Dee-24r/stratosphere/assets/gamecontroller.png

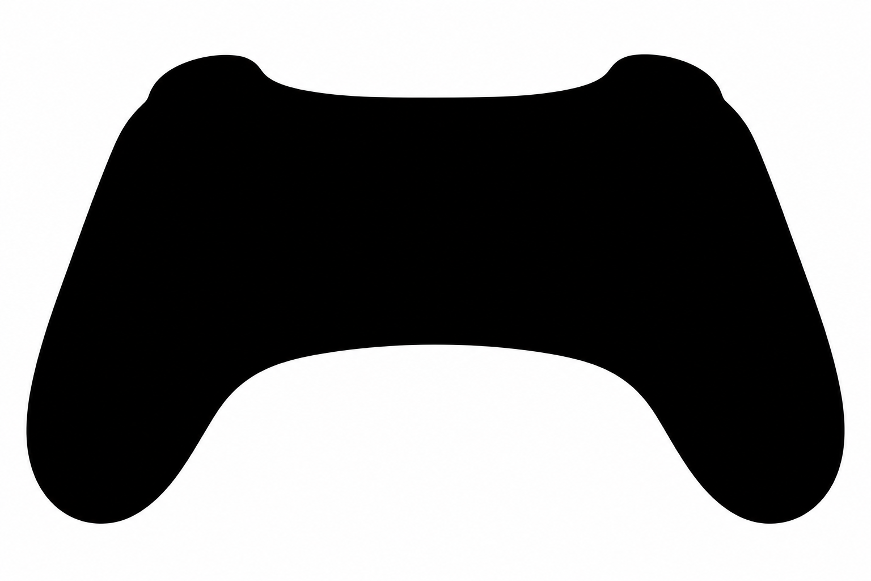
assets/gamecontroller.png
