Dee-24r/stratosphere/pcb/drone-bom.csv

No. | Quantity | Comment | Designator | Footprint | Value | Manufacturer Part | Manufacturer | Supplier Part | Supplier
1 | 2 | Test-Point | BAT+,BAT- | Test-Point-0.5mm
2 | 4 | 1uF | C1,C2,C3,C4 | C0402 | 1uF | TCC0402X5R105M6R3AT | CCTC(三环) | C2887021 | LCSC
3 | 1 | 1uF | C5 | C0603 | 1uF | CC0603KRX7R7BB105 | YAGEO(国巨) | C106248 | LCSC
4 | 2 | 10uF | C6,C11 | C0603 | 10uF | CC0603MRX5R7BB106 | YAGEO(国巨) | C109457 | LCSC
5 | 2 | 10uF | C7,C8 | C0603 | 10uF | CC0603MRX5R6BB106 | YAGEO(国巨) | C109453 | LCSC
6 | 2 | 10uF | C9,C10 | C0402 | 10uF | CC0402MRX6S5BB106 | YAGEO(国巨) | C1856484 | LCSC
7 | 2 | 1uF | C12,C13 | C0603 | 1uF | CC0603KRX7R9BB105 | YAGEO(国巨) | C559769 | LCSC
8 | 1 | 100nF | C14 | C0603 | 100nF | CC0603KRX7R9BB104 | YAGEO(国巨) | C14663 | LCSC
9 | 4 | 1N4148W | D1,D2,D3,D4 | SOD-123_L2.8-W1.8-LS3.7-RD-1 |  | 1N4148W | JSMSEMI(杰盛微) | C917030 | LCSC
10 | 2 | SS14 | D5,D6 | SMA_L4.3-W2.6-LS5.0-RD |  | SS14 | YONGYUTAI(永裕泰) | C47147601 | LCSC
11 | 4 | PZ254V-11-02P | H1,H2,H3,H4 | HDR-TH_2P-P2.54-V-M |  | PZ254V-11-02P | XFCN(兴飞) | C492401 | LCSC
12 | 1 | 2.2uH | L1 | L0805 | 2.2uH | CMI201209U2R2KT | FH(风华) | C1043 | LCSC
13 | 1 | YLED0603R | LED1 | LED0603-FD |  | YLED0603R | YONGYUTAI(永裕泰) | C19171390 | LCSC
14 | 1 | KT-0603R | LED2 | LED-SMD_L1.6-W0.8-R-RD |  | KT-0603R | KENTO | C2286 | LCSC
15 | 4 | SI2300DS-T1-GE3 | Q1,Q2,Q3,Q4 | SOT-23-3_L2.9-W1.6-P1.90-LS2.8-BR |  | SI2300DS-T1-GE3 | VISHAY(威世) | C72271 | LCSC
16 | 4 | 10kΩ | R1,R2,R3,R4 | R0603 | 10kΩ | FRC0603F1002TS | FOJAN(富捷) | C2906982 | LCSC
17 | 2 | 1kΩ | R5,R6 | R0603 | 1kΩ | RC0603FR-071KL | YAGEO(国巨) | C22548 | LCSC
18 | 2 | 5.1kΩ | R7,R8 | R0603 | 5.1kΩ | RC0603FR-075K1L | YAGEO(国巨) | C105580 | LCSC
19 | 1 | 100Ω | R9 | R0603 | 100Ω | RC0603FR-07100RL | YAGEO(国巨) | C105588 | LCSC
20 | 2 | 100kΩ | R10,R11 | R0603 | 100kΩ | 0603WAF1003T5E | UNI-ROYAL(厚声) | C25803 | LCSC
21 | 2 | 1kΩ | R12,R13 | R0402 | 1kΩ | FRC0402J102 TS | FOJAN(富捷) | C2906899 | LCSC
22 | 1 | 1.1kΩ | R14 | R0603 | 1.1kΩ | RC0603FR-071K1L | YAGEO(国巨) | C137780 | LCSC
23 | 1 | 330Ω | R15 | R0402 | 330Ω | RC0402JR-07330RL | YAGEO(国巨) | C105876 | LCSC
24 | 2 | TSA010B2018A | SW1,SW2 | SW-SMD_L3.9-W3.0-P4.45 |  | TSA010B2018A | BZCN(博众电气) | C2888920 | LCSC
25 | 1 | SS12D07VG6 087 | SW3 | SW-TH_SS12D07VG4 |  | SS12D07VG6 087 | SHOU HAN(首韩) | C2939728 | LCSC
26 | 1 | 2.54-1*8 | U1 | HDR-TH_8P-P2.54-V-M |  | 2.54-1*8 | ZHOURI(洲日) | C5156616 | LCSC
27 | 1 | TP4056 | U2 | ESOP-8_L4.9-W3.9-P1.27-LS6.0-BL-EP |  | TP4056 | UMW(友台半导体) | C725790 | LCSC
28 | 1 | TPS63001DRCR | U3 | VSON-10_L3.0-W3.0-P0.50-TL-EP_TPS62410DRCR |  | TPS63001DRCR | TI(德州仪器) | C28060 | LCSC
29 | 1 | YLED0603G | U4 | LED0603-FD |  | YLED0603G | YONGYUTAI(永裕泰) | C19273151 | LCSC
30 | 1 | 2.4GHz | U5 | WIRELM-SMD_ESP32-S3-WROOM-1 | 2.4GHz | ESP32-S3-WROOM-1-N16R8 | ESPRESSIF(乐鑫) | C2913202 | LCSC
31 | 1 | MC-403L68-Z10 | USB3 | USB-TYPE-C-SMD_MC-403L68-Z10 |  | MC-403L68-Z10 | HANBO(汉博) | C47326496 | LCSC
