Dee-24r/stratosphere/assets/new-control-step.step

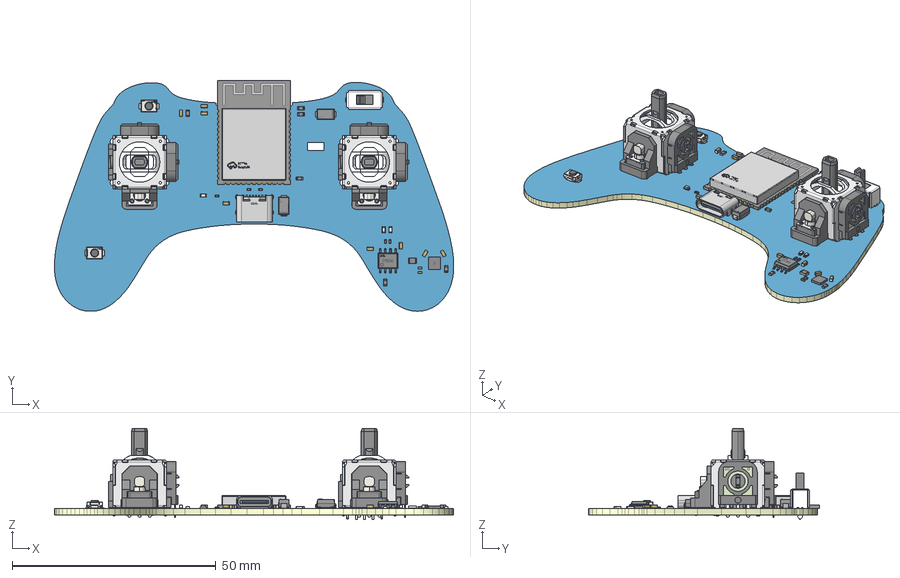
[picture p8: CAD file, 2026-11-08]
assets/new-control-step.step
98.0 x 56.6 x 22.4 mm
Board~3STp
TopCopper~3STp
BottomCopper~3STp
TopSilkscreen~3STp
BottomSilkscreen~3STp
TopFpcStiffener~3STp
BottomFpcStiffener~3STp
R0402~R0402_L1.0-W0.5-H0.4~BPKo x 5
SMA_L4.3-W2.6-LS5.0-RD~SMA_L4.3-W2.6-LS5.0-RD~HQWF x 2
C0603~C0603_L1.6-W0.8-H0.8~hneH x 8
L0805~R0805_L2.0-W1.3-H0.6~7Ztj
R0603~R0603~T6XA x 6
SW-SMD_L3.9-W3.0-P4.45~SW-SMD_L3.9-W2.9-H2.0-LS4.8~sBa6 x 2
C0402~C0402_L1.0-W0.5-H0.5~hx1S x 2
VSON-10_L3.0-W3.0-P0.50-TL-EP_TPS62410DRCR~VSON-10_L3.0-W3.0-H0.6-P0.50_TPS~7Heo
LED-SMD_L1.6-W0.8-R-RD~LED0603_L1.6-W0.8-H0.6~277s
SW-TH_SS12D07VG4~SW-TH_SS12D07VG4~FqVL
USB-TYPE-C-SMD_MC-403L68-Z10~USB-TYPE-C-SMD_MC-403L68-Z10~RNw2
LED0603-FD~LED0603_Inf~H2iq x 2
WIRELM-SMD_ESP32-S3-WROOM-1~WIRELM-SMD_ESP32-S3-WROOM-1~zlgh
ESOP-8_L4.9-W3.9-P1.27-LS6.0-BL-EP~ESOP-8_L4.9-W3.9-H1.6-LS6.0-P1.27~x5o8
SW-TH_RKJXV1224005~SW-TH_RKJXV1224005~T7uV x 2
