Dee-24r/stratosphere/assets/drone.dxf

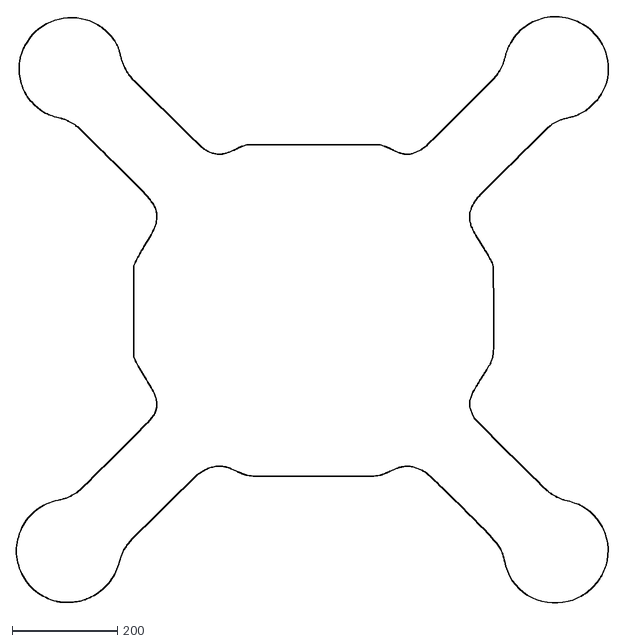
[picture p9: CAD file, 2026-11-05]
assets/drone.dxf
1123.6 x 1113.4
