Dee-24r/stratosphere/assets/game-controller.dxf

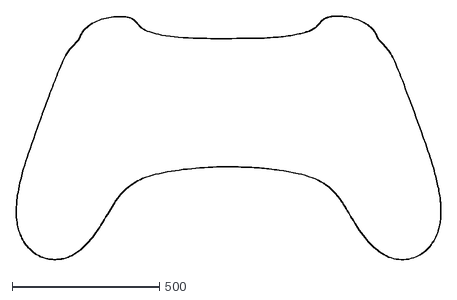
[picture p10: CAD file, 2026-11-05]
assets/game-controller.dxf
1441.5 x 827.3
