Dee-24r/stratosphere/src/drone/config.h

#pragma once

#define MOTOR_1_PIN 4
#define MOTOR_2_PIN 5
#define MOTOR_3_PIN 6
#define MOTOR_4_PIN 7

#define ADC_BAT 1
#define I2C_SDA 9
#define I2C_SCL 10

#define BAT_LED 47

#define MPU6050_ADDR 0x68

#define const int PWM_FREQUENCY = 20000
#define PWM_RES = 8
