Dee-24r/stratosphere/(commit log)

2026-11-03 Update JOURNAL with PCB and CAD progress
    Document progress on PCB design and CAD work for the drone remote, including motor hole addition and troubleshooting in Onshape.
2026-11-05 journals, images, and assets!
    [drone.dxf, game-controller.dxf]
2026-11-07 mpu gyro and accelerometer setup plus read values
2026-11-07 stabilise motors function, still calculating roll and pitch
    [components.cpp, config.h]
2026-11-08 motors initialise and stabilise function, joysticks steup and read values functions
    [components.cpp, components.h, config.h, main.ino]
2026-11-08 esp_now functions, added inidictaion LEDs to the schematic, cuz no screen, so function to turn on LED
2026-11-08 funmi journals
    Added updates about assembly and PCB modifications, including the addition of indication LEDs and a hole for the LED on the remote.
2026-11-08 battery indication led in the drone asw
